coopeeo/shipwrecked-pcb/README.md

View this project on [CADLAB.io](https://cadlab.io/project/29385). 

# shipwrecked-pcb
Shipwrecked PCB Badges
