coopeeo/shipwrecked-pcb/PCB-Schematic/shipwreckedpcb/production/settings.md

# Fabrication Settings

| Name | Value |
|---|---|
| Layers | 4 |
| Stackup (JLC Only) | 3313 |
| Thickness | 1.6mm |
