coopeeo/shipwrecked-pcb/PCB-Schematic/shipwreckedpcb/production/shipwreckedpcb-bom.csv

Reference | Qty | Comment | Footprint | LCSC Part
C1,C2,C5,C6,C7,C8,C9,C10,C11,C12,C56,C65,C66 | 13 | 100nF | Capacitor_SMD:C_0603_1608Metric | C14663
C3,C4,C15,C16,C17,C18,C19,C20,C23,C26,C52 | 11 | 1uF 25v | Capacitor_SMD:C_0603_1608Metric | C15849
C13,C14 | 2 | 15pF | Capacitor_SMD:C_0603_1608Metric | C1644
C21,C22 | 2 | 4.7uF 25v | Capacitor_SMD:C_0603_1608Metric | C69335
C51,C53,C54,C55,C60,C61 | 6 | 10uF | Capacitor_SMD:C_0603_1608Metric | C96446
C57 | 1 | 47nF | Capacitor_SMD:C_0603_1608Metric | C1622
C62 | 1 | 47pF | Capacitor_SMD:C_0603_1608Metric | C1671
C63 | 1 | 39pF | Capacitor_SMD:C_0603_1608Metric | C1666
C64 | 1 | 1nF | Capacitor_SMD:C_0603_1608Metric | C1588
C67 | 1 | 470nF | Capacitor_SMD:C_0603_1608Metric | C1623
C68,C69 | 2 | 3.3pF | Capacitor_SMD:C_0603_1608Metric | C1660
D1 | 1 | D | Diode_SMD:D_SOD-123F | C2892326
D2,D3,D4 | 3 | MBR0530 | Diode_SMD:D_SOD-123 | C77336
FB1 | 1 | BLM18AG601SN1D | Resistor_SMD:R_0603_1608Metric | C19330
FL1 | 1 | 0900FM15D0039 - CONSIGNED | RF_Converter:Balun_Johanson_0900FM15K0039 | C1513363
J1 | 1 | USB4105 | Connector_USB:USB_C_Receptacle_GCT_USB4105-xx-A_16P_TopMnt_Horizontal | C3020560
J2 | 1 | Waveshare 1.54" E-Ink | Connector_FFC-FPC:TE_2-1734839-4_1x24-1MP_P0.5mm_Horizontal | C5362165
L1 | 1 | 10uH | Inductor_SMD:L_APV_ANR4018 | C167808
L9 | 1 | 2.2uH | Inductor_SMD:L_Taiyo-Yuden_NR-30xx | C6364793
L10 | 1 | 47nH | Inductor_SMD:L_0603_1608Metric | C285885
L11 | 1 | 15uH | Inductor_SMD:L_0805_2012Metric | C383402
L12 | 1 | 9.1nH | Inductor_SMD:L_0603_1608Metric | C77125
Q1 | 1 | Si1308EDL | Package_TO_SOT_SMD:SOT-323_SC-70 | C7603347
R1,R7 | 2 | 1k | Resistor_SMD:R_0603_1608Metric | C21190
R2,R3 | 2 | 27.4 | Resistor_SMD:R_0603_1608Metric | C22926
R4,R5 | 2 | 5k1 | Resistor_SMD:R_0603_1608Metric | C23186
R6,R20,R21,R22 | 4 | 10k | Resistor_SMD:R_0603_1608Metric | C25804
R8 | 1 | 2.2 | Resistor_SMD:R_0603_1608Metric | C22939
R9,R18 | 2 | 1M | Resistor_SMD:R_0603_1608Metric | C22935
R19 | 1 | 180k | Resistor_SMD:R_0603_1608Metric | C22827
R23 | 1 | 100 | Resistor_SMD:R_0603_1608Metric | C22775
R24 | 1 | 330 | Resistor_SMD:R_0603_1608Metric | C23138
SW1 | 1 | BOOTSEL | Button_Switch_SMD:SW_Tactile_SPST_NO_Straight_CK_PTS636Sx25SMTRLFS | C318938
SW2 | 1 | RESET | Button_Switch_SMD:SW_Tactile_SPST_NO_Straight_CK_PTS636Sx25SMTRLFS | C318938
SW19 | 1 | PWR Switch | Button_Switch_SMD:SW_SPDT_PCM12 | C319020
U1 | 1 | RP2040 | Package_DFN_QFN:QFN-56-1EP_7x7mm_P0.4mm_EP3.2x3.2mm | C2040
U2 | 1 | W25Q128JVS | Package_SO:SOIC-8_5.3x5.3mm_P1.27mm | C97521
U3 | 1 | PE4259 | Package_TO_SOT_SMD:SOT-363_SC-70-6 | C470892
U4 | 1 | TPS61200DRC | Package_SON:Texas_S-PVSON-N10_ThermalVias | C140320
U6 | 1 | AMS1117-3.3 | Package_TO_SOT_SMD:SOT-223-3_TabPin2 | C18906017
U7 | 1 | PCA9555PW | Package_SO:TSSOP-24_4.4x7.8mm_P0.65mm | C128392
U8 | 1 | SX1262IMLTRT | Package_DFN_QFN:QFN-24-1EP_4x4mm_P0.5mm_EP2.6x2.6mm | C191341
Y1 | 1 | 12MHz | Crystal:Crystal_SMD_Abracon_ABM8G-4Pin_3.2x2.5mm | C9002
Y2 | 1 | 32MHz | Crystal:Crystal_SMD_3225-4Pin_3.2x2.5mm | C19723365
