coopeeo/shipwrecked-pcb/PCB-Schematic/shipwreckedpcb/shipwreckedpcb.kicad_pcb

## KiCad design PCB-Schematic/shipwreckedpcb/shipwreckedpcb.kicad_pcb (2025-08-02)

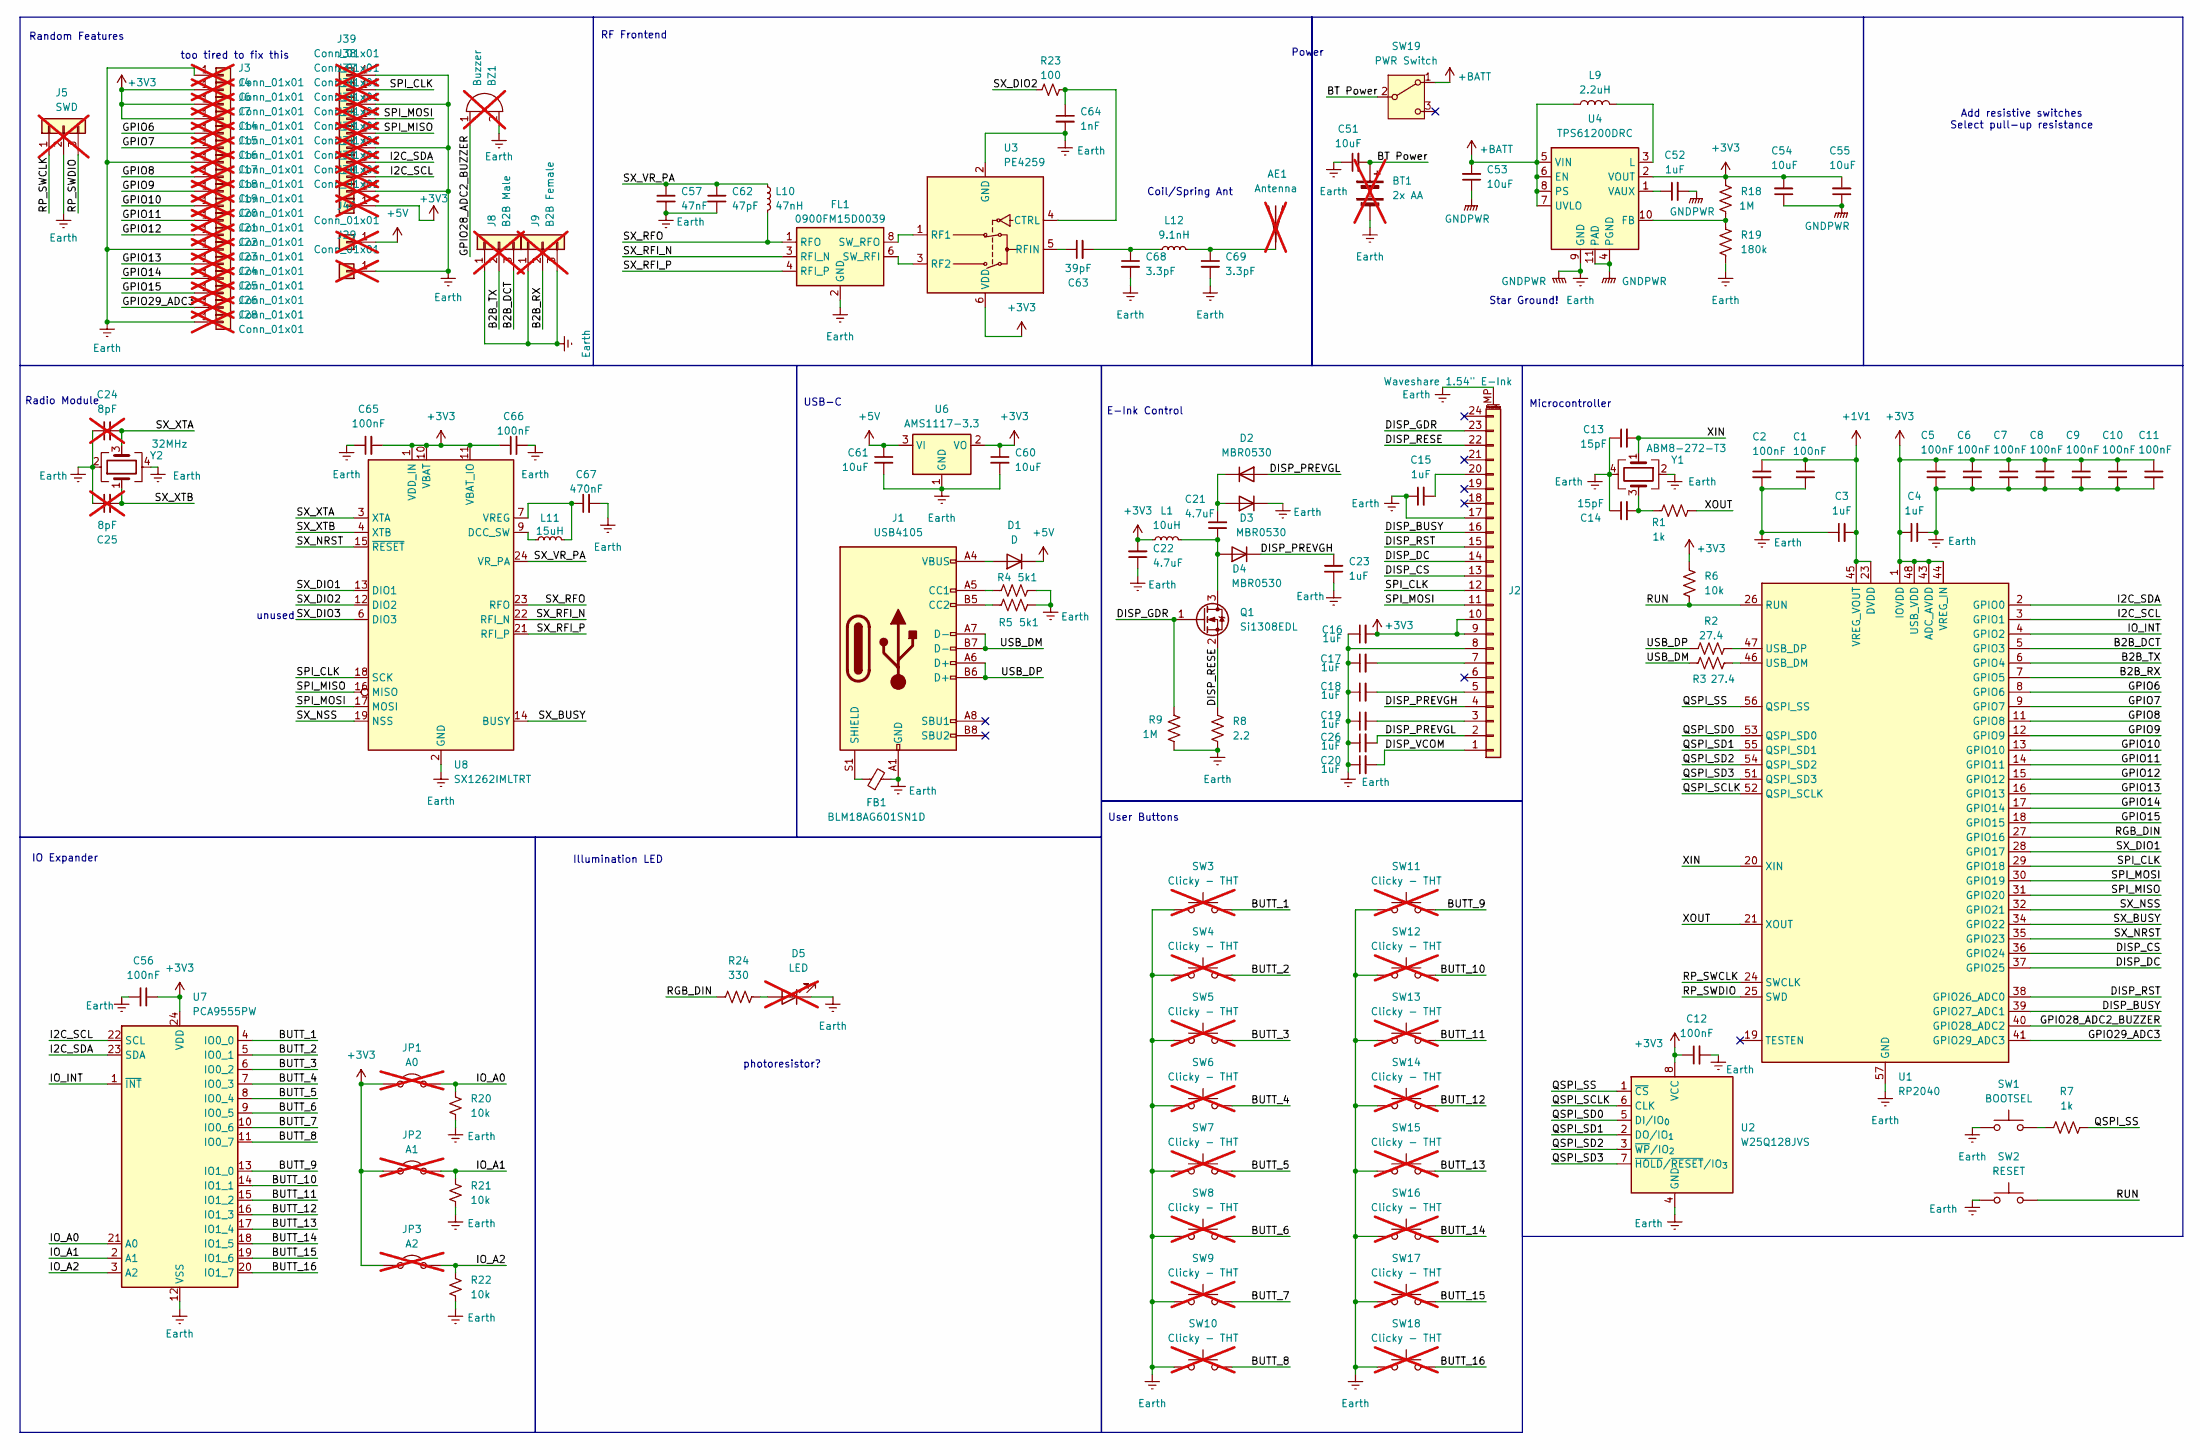
[picture p1: schematic shipwreckedpcb.kicad_sch]

Parts:
AE1: Antenna; PinSocket_1x01_P2.54mm_Vertical; not fitted
BT1: 2x AA; BatteryHolder_Keystone_2462_2xAA; not fitted
BZ1: Buzzer; Buzzer_D14mm_H7mm_P10mm; not fitted
C1, C2, C5, C6, C7, C8, C9, C10, C11, C12, C56, C65, C66: 100nF; C_0603_1608Metric; MPN CC0603KRX7R9BB104; LCSC Part C14663
C3, C4, C15, C16, C17, C18, C19, C20, C23, C26, C52: 1uF; C_0603_1608Metric; MPN CL10A105KB8NNNC; LCSC Part C15849
C13, C14: 15pF; C_0603_1608Metric; MPN CC0603JRNPO9BN150; LCSC Part C1644
C21, C22: 4.7uF; C_0603_1608Metric; MPN CL10A475KA8NQNC; LCSC Part C69335
C24, C25: 8pF; C_0603_1608Metric; MPN CC0603CRNPO9BN8R0; not fitted
C51, C53, C54, C55, C60, C61: 10uF; C_0603_1608Metric; MPN CL10A106KP8NNNC; LCSC Part C96446
C57: 47nF; C_0603_1608Metric; MPN CC0603KRX7R9BB473; LCSC Part C1622
C62: 47pF; C_0603_1608Metric; MPN CC0603JRNPO9BN470; LCSC Part C1671
C63: 39pF; C_0603_1608Metric; MPN CC0603JRNPO9BN101; LCSC Part C1666
C64: 1nF; C_0603_1608Metric; MPN CC0603KRX7R9BB102; LCSC Part C1588
C67: 470nF; C_0603_1608Metric; MPN CL10B474KA8NNNC; LCSC Part C1623
C68, C69: 3.3pF; C_0603_1608Metric; MPN 0603CG3R3C500NT; LCSC Part C1660
D1: D; D_SOD-123F; MPN 1N4001; LCSC Part C2892326
D2, D3, D4: MBR0530; D_SOD-123; MPN MBR0530T1G; LCSC Part C77336
D5: LED; LED_D5.0mm; MPN DY-324SVRC-H23-P-A4(FH); not fitted
FB1: BLM18AG601SN1D; R_0603_1608Metric; MPN BLM18AG601SN1D; LCSC Part C19330
FL1: 0900FM15D0039; Balun_Johanson_0900FM15K0039; MPN 0900FM15K0039E; LCSC Part consigned
J1: USB4105; USB_C_Receptacle_GCT_USB4105-xx-A_16P_TopMnt_Horizontal; MPN USB4105-GF-A; LCSC Part C3020560
J2: Waveshare 1.54" E-Ink; TE_2-1734839-4_1x24-1MP_P0.5mm_Horizontal; MPN 05B20U24P; LCSC Part C5362165
J3, J4, J6, J7, J14, J15, J16, J17, J18, J19, J20, J21, J22, J23, J24, J25, J26, J28, J29, J30, J31, J32, J33, J34, J35, J36, J37, J38, J39, J40: Conn_01x01; SolderWirePad_1x01_SMD_1x2mm; not fitted
J5: SWD; PinSocket_1x03_P2.54mm_Vertical; not fitted
J8: B2B Male; PinHeader_1x03_P2.54mm_Horizontal; not fitted
J9: B2B Female; PinSocket_1x03_P2.54mm_Horizontal; not fitted
JP1: A0; SolderJumper-2_P1.3mm_Open_RoundedPad1.0x1.5mm; not fitted
JP2: A1; SolderJumper-2_P1.3mm_Open_RoundedPad1.0x1.5mm; not fitted
JP3: A2; SolderJumper-2_P1.3mm_Open_RoundedPad1.0x1.5mm; not fitted
L1: 10uH; L_APV_ANR4018; MPN FNR4018S100MT; LCSC Part C167808
L9: 2.2uH; L_Taiyo-Yuden_NR-30xx; MPN NR3015T2R2M; LCSC Part C6364793
L10: 47nH; L_0603_1608Metric; MPN LS0603-47NJ-N; LCSC Part C285885
L11: 15uH; L_0805_2012Metric; MPN MLZ2012M150WT000; LCSC Part C383402
L12: 9.1nH; L_0603_1608Metric; MPN LS0603-47NJ-N; LCSC Part C334262
Q1: Si1308EDL; SOT-323_SC-70; MPN SI1308EDL; LCSC Part C7603347
R1, R7: 1k; R_0603_1608Metric; MPN RC0603FR-071KL; LCSC Part C21190
R2, R3: 27.4; R_0603_1608Metric; MPN FRC0603F27R4TS; LCSC Part C22926
R4, R5: 5k1; R_0603_1608Metric; MPN FRC0603F5101TS; LCSC Part C23186
R6, R20, R21, R22: 10k; R_0603_1608Metric; MPN RC0603FR-0710KL; LCSC Part C25804
R8: 2.2; R_0603_1608Metric; MPN CRCW06033R00FKEA; LCSC Part C22939
R9, R18: 1M; R_0603_1608Metric; MPN RC0603FR-071ML; LCSC Part C22935
R19: 180k; R_0603_1608Metric; MPN FRC0603F1803TS; LCSC Part C22827
R23: 100; R_0603_1608Metric; MPN RC0603FR-07100RL; LCSC Part C22775
R24: 330; R_0603_1608Metric; MPN RC0603FR-07330RL; LCSC Part C23138
SW1: BOOTSEL; SW_Tactile_SPST_NO_Straight_CK_PTS636Sx25SMTRLFS; MPN TS-1101-C-W; LCSC Part C318938
SW2: RESET; SW_Tactile_SPST_NO_Straight_CK_PTS636Sx25SMTRLFS; MPN TS-1101-C-W; LCSC Part C318938
SW3, SW4, SW5, SW6, SW7, SW8, SW9, SW10, SW11, SW12, SW13, SW14, SW15, SW16, SW17, SW18: Clicky - THT; SW_PUSH_6mm; MPN SH-6X6X4.3H-CJ; not fitted
SW19: PWR Switch; SW_SPDT_PCM12; MPN SK-3296S-01-L1; LCSC Part C319020
U1: RP2040; QFN-56-1EP_7x7mm_P0.4mm_EP3.2x3.2mm; MPN RP2040; LCSC Part C2040
U2: W25Q128JVS; SOIC-8_5.3x5.3mm_P1.27mm; MPN W25Q128JVSIQ; LCSC Part C97521
U3: PE4259; SOT-363_SC-70-6; MPN PE4259-63; LCSC Part C470892
U4: TPS61200DRC; Texas_S-PVSON-N10_ThermalVias; MPN TPS61200DRCR; LCSC Part C140320
U6: AMS1117-3.3; SOT-223-3_TabPin2; MPN AMS1117-3.3V; LCSC Part C18906017
U7: PCA9555PW; TSSOP-24_4.4x7.8mm_P0.65mm; MPN PCA9555PW,118; LCSC Part C128392
U8: SX1262IMLTRT; QFN-24-1EP_4x4mm_P0.5mm_EP2.6x2.6mm; MPN SX1262IMLTRT; LCSC Part C191341
Y1: ABM8-272-T3; Crystal_SMD_Abracon_ABM8G-4Pin_3.2x2.5mm; MPN XL2EL89CMI-111YLC-12M; LCSC Part C9002
Y2: 32MHz; Crystal_SMD_3225-4Pin_3.2x2.5mm; MPN XTM32032000DT00351001; LCSC Part C19723365

Connections:
+1V1: C1.1, C2.1, C3.2, U1.23 (DVDD), U1.45 (VREG_VOUT), U1.50 (DVDD)
+3V3: C4.1, C5.1, C6.1, C7.1, C8.1, C9.1, C10.1, C11.1, C12.1, C16.2, C22.2, C54.2, C55.2, C56.1, C60.1, C65.2, C66.1, J2.9, J2.10, J4.1, J6.1, J7.1, J30.1, JP1.1 (A), JP2.1 (A), JP3.1 (A), L1.1, R6.1, R18.1, U1.1 (IOVDD), U1.10 (IOVDD), U1.22 (IOVDD), U1.33 (IOVDD), U1.42 (IOVDD), U1.43 (ADC_AVDD), U1.44 (VREG_IN), U1.48 (USB_VDD), U1.49 (IOVDD), U2.8 (VCC), U3.6 (VDD), U4.2 (VOUT), U6.2 (VO), U7.24 (VDD), U8.1 (VDD_IN), U8.10 (VBAT), U8.11 (VBAT_IO)
+5V: C61.1, D1.1 (K), J40.1, U6.3 (VI)
+BATT: C53.2, L9.1, SW19.1 (A), U4.5 (VIN), U4.6 (EN), U4.7 (UVLO), U4.8 (PS)
/B2B_DCT: J8.3, U1.5 (GPIO3)
/B2B_RX: J9.2, U1.7 (GPIO5)
/B2B_TX: J8.2, U1.6 (GPIO4)
/BT Power: BT1.1 (+), C51.2, SW19.2 (B)
/BUTT_1: SW3.2, U7.4 (IO0_0)
/BUTT_2: SW4.2, U7.5 (IO0_1)
/BUTT_3: SW5.2, U7.6 (IO0_2)
/BUTT_4: SW6.2, U7.7 (IO0_3)
/BUTT_5: SW7.2, U7.8 (IO0_4)
/BUTT_6: SW8.2, U7.9 (IO0_5)
/BUTT_7: SW9.2, U7.10 (IO0_6)
/BUTT_8: SW10.2, U7.11 (IO0_7)
/BUTT_9: SW11.2, U7.13 (IO1_0)
/BUTT_10: SW12.2, U7.14 (IO1_1)
/BUTT_11: SW13.2, U7.15 (IO1_2)
/BUTT_12: SW14.2, U7.16 (IO1_3)
/BUTT_13: SW15.2, U7.17 (IO1_4)
/BUTT_14: SW16.2, U7.18 (IO1_5)
/BUTT_15: SW17.2, U7.19 (IO1_6)
/BUTT_16: SW18.2, U7.20 (IO1_7)
/DISP_BUSY: J2.16, U1.39 (GPIO27_ADC1)
/DISP_CS: J2.13, U1.36 (GPIO24)
/DISP_DC: J2.14, U1.37 (GPIO25)
/DISP_GDR: J2.23, Q1.1 (G), R9.1
/DISP_PREVGH: C23.2, D4.1 (K), J2.4
/DISP_PREVGL: C26.2, D2.2 (A), J2.2
/DISP_RESE: J2.22, Q1.2 (S), R8.1
/DISP_RST: J2.15, U1.38 (GPIO26_ADC0)
/DISP_VCOM: C20.2, J2.1
/GPIO6: J14.1, U1.8 (GPIO6)
/GPIO7: J15.1, U1.9 (GPIO7)
/GPIO8: J17.1, U1.11 (GPIO8)
/GPIO9: J18.1, U1.12 (GPIO9)
/GPIO10: J19.1, U1.13 (GPIO10)
/GPIO11: J20.1, U1.14 (GPIO11)
/GPIO12: J21.1, U1.15 (GPIO12)
/GPIO13: J23.1, U1.16 (GPIO13)
/GPIO14: J24.1, U1.17 (GPIO14)
/GPIO15: J25.1, U1.18 (GPIO15)
/GPIO28_ADC2_BUZZER: BZ1.1 (+), U1.40 (GPIO28_ADC2)
/GPIO29_ADC3: J26.1, U1.41 (GPIO29_ADC3)
/I2C_SCL: J32.1, U1.3 (GPIO1), U7.22 (SCL)
/I2C_SDA: J33.1, U1.2 (GPIO0), U7.23 (SDA)
/IO_A0: JP1.2 (B), R20.1, U7.21 (A0)
/IO_A1: JP2.2 (B), R21.1, U7.2 (A1)
/IO_A2: JP3.2 (B), R22.1, U7.3 (A2)
/IO_INT: U1.4 (GPIO2), U7.1 (~INT)
/QSPI_SCLK: U1.52 (QSPI_SCLK), U2.6 (CLK)
/QSPI_SD0: U1.53 (QSPI_SD0), U2.5 (DI/IO_{0})
/QSPI_SD1: U1.55 (QSPI_SD1), U2.2 (DO/IO_{1})
/QSPI_SD2: U1.54 (QSPI_SD2), U2.3 (~WP/IO_{2})
/QSPI_SD3: U1.51 (QSPI_SD3), U2.7 (~HOLD/~RESET/IO_{3})
/QSPI_SS: R7.2, U1.56 (QSPI_SS), U2.1 (~CS)
/RGB_DIN: R24.1, U1.27 (GPIO16)
/RP_SWCLK: J5.1, U1.24 (SWCLK)
/RP_SWDIO: J5.3, U1.25 (SWD)
/RUN: R6.2, SW2.2, U1.26 (RUN)
/SPI_CLK: J2.12, J38.1, U1.29 (GPIO18), U8.18 (SCK)
/SPI_MISO: J35.1, U1.31 (GPIO20), U8.16 (MISO)
/SPI_MOSI: J2.11, J36.1, U1.30 (GPIO19), U8.17 (MOSI)
/SX_BUSY: U1.34 (GPIO22), U8.14 (BUSY)
/SX_DIO1: U1.28 (GPIO17), U8.13 (DIO1)
/SX_DIO2: R23.1, U8.12 (DIO2)
/SX_DIO3: U8.6 (DIO3)
/SX_NRST: U1.35 (GPIO23), U8.15 (~RESET)
/SX_NSS: U1.32 (GPIO21), U8.19 (NSS)
/SX_RFI_N: FL1.3 (RFI_N), U8.22 (RFI_N)
/SX_RFI_P: FL1.4 (RFI_P), U8.21 (RFI_P)
/SX_RFO: FL1.1 (RFO), L10.2, U8.23 (RFO)
/SX_VR_PA: C57.1, C62.1, L10.1, U8.24 (VR_PA)
/SX_XTA: C24.2, U8.3 (XTA), Y2.3
/SX_XTB: C25.2, U8.4 (XTB), Y2.1
/USB_DM: J1.A7 (D-), J1.B7 (D-), R3.1
/USB_DP: J1.A6 (D+), J1.B6 (D+), R2.1
/XIN: C13.2, U1.20 (XIN), Y1.1
/XOUT: R1.2, U1.21 (XOUT)
Earth: BT1.2 (-), BZ1.2 (-), C1.2, C2.2, C3.1, C4.2, C5.2, C6.2, C7.2, C8.2, C9.2, C10.2, C11.2, C12.2, C13.1, C14.1, C15.1, C16.1, C17.1, C18.1, C19.1, C20.1, C22.1, C23.1, C24.1, C25.1, C26.1, C51.1, C52.2, C53.1, C54.1, C55.1, C56.2, C57.2, C60.2, C61.2, C62.2, C64.2, C65.1, C66.2, C67.2, C68.2, C69.2, D3.1 (K), D5.1 (K), FB1.2, FL1.2 (GND), FL1.5 (GND), FL1.7 (GND), FL1.9 (GND), FL1.10 (GND), J1.A1 (GND), J1.A12 (GND), J1.B1 (GND), J1.B12 (GND), J2.8, J2.17, J2.MP (MountPin), J3.1, J5.2, J8.1, J9.1, J9.3, J16.1, J22.1, J28.1, J29.1, J31.1, J34.1, J37.1, J39.1, R4.2, R5.2, R8.2, R9.2, R19.2, R20.2, R21.2, R22.2, SW1.1, SW2.1, SW3.1, SW4.1, SW5.1, SW6.1, SW7.1, SW8.1, SW9.1, SW10.1, SW11.1, SW12.1, SW13.1, SW14.1, SW15.1, SW16.1, SW17.1, SW18.1, U1.57 (GND), U2.4 (GND), U3.2 (GND), U4.4 (PGND), U4.9 (GND), U4.11 (PAD), U6.1 (GND), U7.12 (VSS), U8.2 (GND), U8.5 (GND), U8.8 (GND), U8.20 (GND), U8.25 (GND), Y1.2, Y1.4, Y2.2, Y2.4
unnamed: AE1.1 (A), C69.1, L12.2
unnamed: C14.2, R1.1, Y1.3
unnamed: C63.2, C68.1, L12.1
unnamed: D1.2 (A), J1.A4 (VBUS), J1.A9 (VBUS), J1.B4 (VBUS), J1.B9 (VBUS)
unnamed: C21.2, D2.1 (K), D3.2 (A)
unnamed: C21.1, D4.2 (A), L1.2, Q1.3 (D)
unnamed: D5.2 (A), R24.2
unnamed: FL1.6 (SW_RFI), U3.3 (RF2)
unnamed: FL1.8 (SW_RFO), U3.1 (RF1)
unnamed: J1.A5 (CC1), R4.1
unnamed: J1.B5 (CC2), R5.1
unnamed: FB1.1, J1.S1 (SHIELD)
unnamed: C19.2, J2.3
unnamed: C18.2, J2.5
unnamed: C17.2, J2.7
unnamed: C15.2, J2.20
unnamed: R7.1, SW1.2
unnamed: R3.2, U1.46 (USB_DM)
unnamed: R2.2, U1.47 (USB_DP)
unnamed: C64.1, R23.2, U3.4 (CTRL)
unnamed: C63.1, U3.5 (RFIN)
unnamed: R18.2, R19.1, U4.10 (FB)
unnamed: L9.2, U4.3 (L)
unnamed: C52.1, U4.1 (VAUX)
unnamed: L11.1, U8.9 (DCC_SW)
unnamed: C67.1, L11.2, U8.7 (VREG)

Notes on the sheet:
IO Expander
photoresistor?
Illumination LED
Power
Add resistive switches Select pull-up resistance
Microcontroller
E-Ink Control
unused
User Buttons
Star Ground!
too tired to fix this
Coil/Spring Ant
Random Features
RF Frontend
USB-C
Radio Module

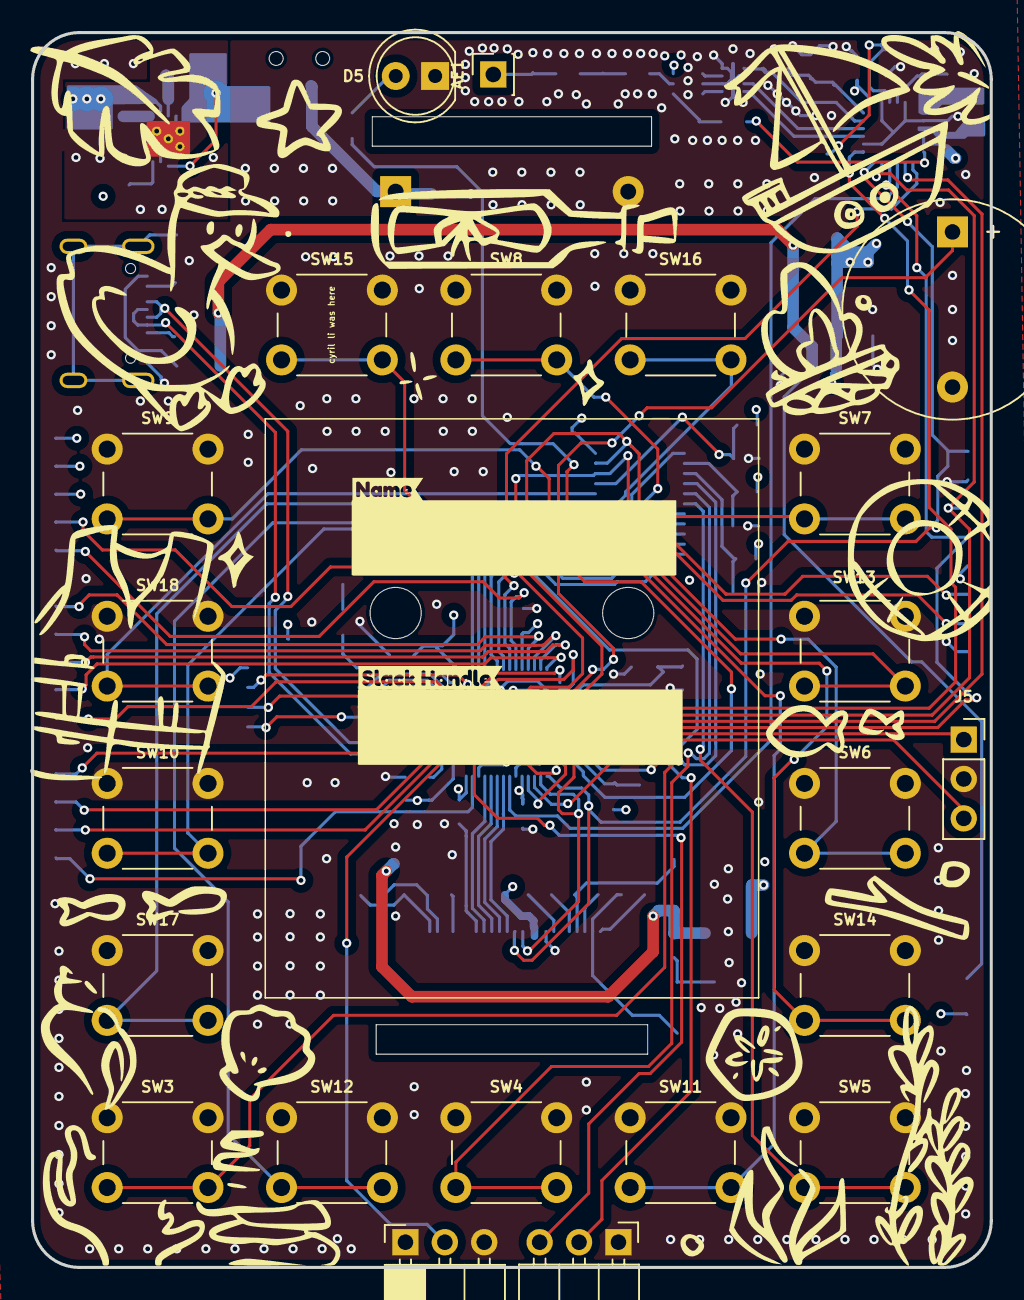
[picture p2: board shipwreckedpcb.kicad_pcb from above]

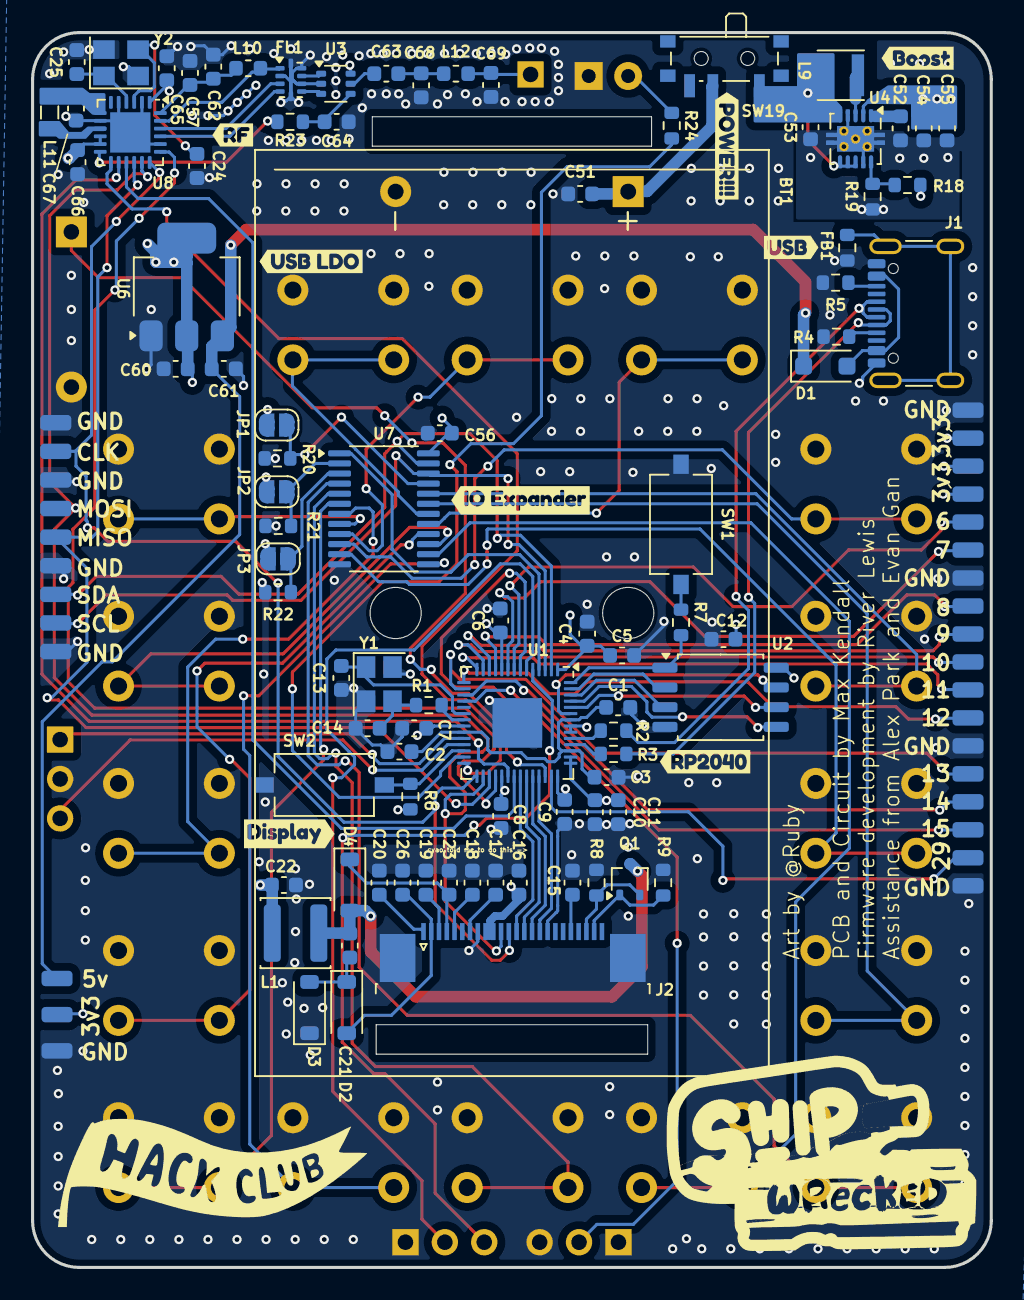
[picture p3: board shipwreckedpcb.kicad_pcb from below]

Board: 4 copper layers, 61.8 x 79.6 mm, 151 parts (127 on the bottom side), 106 nets.

Other parts of the board:
kibuzzard-687A9D67: G***; kibuzzard-687A9D67
kibuzzard-687A9DB2: G***; kibuzzard-687A9DB2
kibuzzard-687ADB8B: G***; kibuzzard-687ADB8B
kibuzzard-687864C4: G***; kibuzzard-687864C4
kibuzzard-687865CB: G***; kibuzzard-687865CB
kibuzzard-6878653F: G***; kibuzzard-6878653F
kibuzzard-6878659A: G***; kibuzzard-6878659A
kibuzzard-68786508: G***; kibuzzard-68786508
kibuzzard-68786528: G***; kibuzzard-68786528
kibuzzard-68786588: G***; kibuzzard-68786588
