coopeeo/shipwrecked-pcb/Code/internal_os/notifs.py

class NotifManager:
    """
    The NotifManager class is responsible for managing notifications on the badge.
    It handles notification creation, display, and interaction.
    """
    # TODO
    pass
