coopeeo/shipwrecked-pcb/badge-selftest/disp/main.py

import machine
import utime

#EPD GPIO
isEPD_W21_BUSY=machine.Pin(27, machine.Pin.IN, machine.Pin.PULL_DOWN) #BUSY
EPD_W21_RST= machine.Pin(26, machine.Pin.OUT)#RESE
EPD_W21_DC= machine.Pin(25, machine.Pin.OUT)#DC
EPD_W21_CS= machine.Pin(24, machine.Pin.OUT)#CS
#SPI0
spi_sck=machine.Pin(18) #SCLK
spi_tx=machine.Pin(19)#SDIN
spi_rx=machine.Pin(20)
spi=machine.SPI(0,baudrate=10000000,sck=spi_sck, mosi=spi_tx, miso=spi_rx) #10Mhz

#LED
led_onboard = machine.Pin(16, machine.Pin.OUT)
#PICTURE
Num= [
#0
[
0XFF,0XFF,0XFF,0XFF,0XFF,0XFF,0XFF,0XFF,0XFF,0XFF,0XFF,0XFF,0XFF,0XFF,0XFF,0XFF,
0XFF,0XFF,0XFF,0XE0,0X03,0XFF,0XFF,0XFF,0XFF,0XFF,0XFC,0X00,0X00,0X1F,0XFF,0XFF,
0XFF,0XFF,0XE0,0X00,0X00,0X03,0XFF,0XFF,0XFF,0XFF,0X80,0X00,0X00,0X00,0XFF,0XFF,
0XFF,0XFE,0X00,0X00,0X00,0X00,0X3F,0XFF,0XFF,0XFC,0X00,0X00,0X00,0X00,0X1F,0XFF,
0XFF,0XF8,0X00,0X00,0X00,0X00,0X0F,0XFF,0XFF,0XF0,0X03,0XFF,0XFF,0XE0,0X07,0XFF,
0XFF,0XE0,0X3F,0XFF,0XFF,0XFE,0X03,0XFF,0XFF,0XE0,0XFF,0XFF,0XFF,0XFF,0X83,0XFF,
0XFF,0XC1,0XFF,0XFF,0XFF,0XFF,0XC1,0XFF,0XFF,0XC7,0XFF,0XFF,0XFF,0XFF,0XF1,0XFF,
0XFF,0XC7,0XFF,0XFF,0XFF,0XFF,0XF1,0XFF,0XFF,0XCF,0XFF,0XFF,0XFF,0XFF,0XF9,0XFF,
0XFF,0XCF,0XFF,0XFF,0XFF,0XFF,0XF9,0XFF,0XFF,0XC7,0XFF,0XFF,0XFF,0XFF,0XF1,0XFF,
0XFF,0XC7,0XFF,0XFF,0XFF,0XFF,0XF1,0XFF,0XFF,0XC3,0XFF,0XFF,0XFF,0XFF,0XE1,0XFF,
0XFF,0XE0,0XFF,0XFF,0XFF,0XFF,0X83,0XFF,0XFF,0XE0,0X3F,0XFF,0XFF,0XFE,0X03,0XFF,
0XFF,0XF0,0X03,0XFF,0XFF,0XC0,0X07,0XFF,0XFF,0XF8,0X00,0X00,0X00,0X00,0X0F,0XFF,
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

    Epaper_Write_Command(0x45) #set Ram-Y address start/end position          
    Epaper_Write_Data(0xC7)    #0xC7-->(199+1)=200
    Epaper_Write_Data(0x00)
    Epaper_Write_Data(0x00)
    Epaper_Write_Data(0x00) 

    Epaper_Write_Command(0x3C) #BorderWavefrom,
    Epaper_Write_Data(0x05)	

    Epaper_Write_Command(0x18) #Read built-in temperature sensor
    Epaper_Write_Data(0x80)	

    Epaper_Write_Command(0x4E)   # set RAM x address count to 0
    Epaper_Write_Data(0x00)
    Epaper_Write_Command(0x4F)   # set RAM y address count to 0X199    
    Epaper_Write_Data(0xC7)
    Epaper_Write_Data(0x00)
    Epaper_READBUSY()
	
def EPD_Update(): 
    Epaper_Write_Command(0x22) #Display Update Control
    Epaper_Write_Data(0xF7)   
    Epaper_Write_Command(0x20) #Activate Display Update Sequence
    Epaper_READBUSY()   

#When the electronic paper screen is updated, do not unplug the electronic paper to avoid damage to the screen*/
def EPD_Part_Update():
	Epaper_Write_Command(0x22) #Display Update Control
	Epaper_Write_Data(0xFF)   
	Epaper_Write_Command(0x20) #Activate Display Update Sequence
	Epaper_READBUSY() 			

#display 
def EPD_WhiteScreen_ALL(datas):
    Epaper_Write_Command(0x24)   #write RAM for black(0)/white (1)
    for i in range(5000):             
        Epaper_Write_Data(datas[i])
    EPD_Update()	 

#The x axis is reduced by one byte, and the y axis is reduced by one pixel.
def EPD_SetRAMValue_BaseMap(datas):	
    Epaper_Write_Command(0x24)   #Write Black and White image to RAM
    for i in range(5000):             
        Epaper_Write_Data(datas[i])
    Epaper_Write_Command(0x26)   #Write Black and White image to RAM
    for i in range(5000):             
        Epaper_Write_Data(datas[i])
    EPD_Update()		 

def EPD_Dis_Part(x_start,y_start,datas,PART_COLUMN,PART_LINE):
    x_start=x_start//8
    x_end=x_start+PART_LINE//8-1 

    y_start1=0
    y_start2=y_start
    if y_start>=256:
        y_start1=y_start2//256
        y_start2=y_start2%256	
    y_end1=0
    y_end2=y_start+PART_COLUMN-1
    if y_end2>=256:
        y_end1=y_end2//256
        y_end2=y_end2%256				
    #Add hardware reset to prevent background color change
    EPD_W21_RST.value(0)  # Module reset   
    utime.sleep(0.01)#At least 10ms delay 
    EPD_W21_RST.value(1)
    utime.sleep(0.01) #At least 10ms delay 	
    #Lock the border to prevent flashing
    Epaper_Write_Command(0x3C) #BorderWavefrom,
    Epaper_Write_Data(0x80)	
    #
    Epaper_Write_Command(0x44)       # set RAM x address start/end, in page 35
    Epaper_Write_Data(x_start)    # RAM x address start at 00h
    Epaper_Write_Data(x_end)    # RAM x address end at 0fh(15+1)*8->128 
    Epaper_Write_Command(0x45)       # set RAM y address start/end, in page 35
    Epaper_Write_Data(y_start2)    # RAM y address start at 0127h
    Epaper_Write_Data(y_start1)    # RAM y address start at 0127h
    Epaper_Write_Data(y_end2)    # RAM y address end at 00h
    Epaper_Write_Data(y_end1)    # ????=0	

    Epaper_Write_Command(0x4E)   # set RAM x address count to 0
    Epaper_Write_Data(x_start) 
    Epaper_Write_Command(0x4F)   # set RAM y address count to 0X127    
    Epaper_Write_Data(y_start2)
    Epaper_Write_Data(y_start1)

    Epaper_Write_Command(0x24)   #Write Black and White image to RAM 
    for i in range(PART_COLUMN*PART_LINE//8):                       
        Epaper_Write_Data(datas[i])
    EPD_Part_Update()


#Clear screen
def PIC_display_Clear():
    #Write Data
    Epaper_Write_Command(0x24)	       #Transfer old data
    for i in range(5000):  	
        Epaper_Write_Data(0xFF) 
    #Refresh
    EPD_Update()
#Enter deep sleep mode 
def EPD_DeepSleep(): 	
    Epaper_Write_Command(0x10) #enter deep sleep
    Epaper_Write_Data(0x01) 
    utime.sleep(0.01)

##################/TIME#########################/
def EPD_Dis_Part_myself(x_startA,y_startA,datasA,
	                    x_startB,y_startB,datasB,
			            x_startC,y_startC,datasC,
		                x_startD,y_startD,datasD,
					    x_startE,y_startE,datasE,PART_COLUMN,PART_LINE):	
	#Data A##############
    x_startA=x_startA//8#Convert to byte
    x_end=x_startA+PART_LINE//8-1 

    y_start1=0
    y_start2=y_startA-1
    if y_startA>=256:
        y_start1=y_start2//256
        y_start2=y_start2%256
    y_end1=0
    y_end2=y_startA+PART_COLUMN-1
    if y_end2>=256:
        y_end1=y_end2//256
        y_end2=y_end2%256				

    # Add hardware reset to prevent background color change
    EPD_W21_RST.value(0)  # Module reset   
    utime.sleep(0.01)#At least 10ms delay 
    EPD_W21_RST.value(1)
    utime.sleep(0.01) #At least 10ms delay 

    #Lock the border to prevent flashing
    Epaper_Write_Command(0x3C) #BorderWavefrom,
    Epaper_Write_Data(0x80)	
    #
    Epaper_Write_Command(0x44)       # set RAM x address start/end, in page 35
    Epaper_Write_Data(x_startA)    # RAM x address start at 00h
    Epaper_Write_Data(x_end)    # RAM x address end at 0fh(15+1)*8->128 
    Epaper_Write_Command(0x45)       # set RAM y address start/end, in page 35
    Epaper_Write_Data(y_start2)    # RAM y address start at 0127h
    Epaper_Write_Data(y_start1)    # RAM y address start at 0127h
    Epaper_Write_Data(y_end2)    # RAM y address end at 00h
    Epaper_Write_Data(y_end1)    

    Epaper_Write_Command(0x4E)   # set RAM x address count to 0
    Epaper_Write_Data(x_startA) 
    Epaper_Write_Command(0x4F)   # set RAM y address count to 0X127    
    Epaper_Write_Data(y_start2)
    Epaper_Write_Data(y_start1)

    Epaper_Write_Command(0x24)   #Write Black and White image to RAM
    for i in range(PART_COLUMN*PART_LINE//8):                         
        Epaper_Write_Data(datasA[i])

    #Data B##################/
    x_startB=x_startB//8#Convert to byte
    x_end=x_startB+PART_LINE//8-1 

    y_start1=0
    y_start2=y_startB-1
    if y_startB>=256:
        y_start1=y_start2//256
        y_start2=y_start2%256
    y_end1=0
    y_end2=y_startB+PART_COLUMN-1
    if y_end2>=256:
        y_end1=y_end2//256
        y_end2=y_end2%256			

    Epaper_Write_Command(0x44)       # set RAM x address start/end, in page 35
    Epaper_Write_Data(x_startB)    # RAM x address start at 00h
    Epaper_Write_Data(x_end)    # RAM x address end at 0fh(15+1)*8->128 
    Epaper_Write_Command(0x45)       # set RAM y address start/end, in page 35
    Epaper_Write_Data(y_start2)    # RAM y address start at 0127h
    Epaper_Write_Data(y_start1)    # RAM y address start at 0127h
    Epaper_Write_Data(y_end2)    # RAM y address end at 00h
    Epaper_Write_Data(y_end1)   

    Epaper_Write_Command(0x4E)   # set RAM x address count to 0
    Epaper_Write_Data(x_startB) 
    Epaper_Write_Command(0x4F)   # set RAM y address count to 0X127    
    Epaper_Write_Data(y_start2)
    Epaper_Write_Data(y_start1)

    Epaper_Write_Command(0x24)   #Write Black and White image to RAM
    for i in range(PART_COLUMN*PART_LINE//8):                         
        Epaper_Write_Data(datasB[i])	 

    #Data C###################
    x_startC=x_startC//8#Convert to byte
    x_end=x_startC+PART_LINE//8-1 

    y_start1=0
    y_start2=y_startC-1
    if y_startC>=256:
        y_start1=y_start2//256
        y_start2=y_start2%256	
    y_end1=0
    y_end2=y_startC+PART_COLUMN-1
    if y_end2>=256:
        y_end1=y_end2//256
        y_end2=y_end2%256					
    Epaper_Write_Command(0x44)       # set RAM x address start/end, in page 35
    Epaper_Write_Data(x_startC)    # RAM x address start at 00h
    Epaper_Write_Data(x_end)    # RAM x address end at 0fh(15+1)*8->128 
    Epaper_Write_Command(0x45)       # set RAM y address start/end, in page 35
    Epaper_Write_Data(y_start2)    # RAM y address start at 0127h
    Epaper_Write_Data(y_start1)    # RAM y address start at 0127h
    Epaper_Write_Data(y_end2)    # RAM y address end at 00h
    Epaper_Write_Data(y_end1)   

    Epaper_Write_Command(0x4E)   # set RAM x address count to 0
    Epaper_Write_Data(x_startC) 
    Epaper_Write_Command(0x4F)   # set RAM y address count to 0X127    
    Epaper_Write_Data(y_start2)
    Epaper_Write_Data(y_start1)


    Epaper_Write_Command(0x24)   #Write Black and White image to RAM
    for i in range(PART_COLUMN*PART_LINE//8):                         
        Epaper_Write_Data(datasC[i])	 	 

    #Data D###################
    x_startD=x_startD//8#Convert to byte
    x_end=x_startD+PART_LINE//8-1 

    y_start1=0
    y_start2=y_startD-1
    if y_startD>=256:
        y_start1=y_start2//256
        y_start2=y_start2%256
    y_end1=0
    y_end2=y_startD+PART_COLUMN-1
    if y_end2>=256:
        y_end1=y_end2//256
        y_end2=y_end2%256			

    Epaper_Write_Command(0x44)       # set RAM x address start/end, in page 35
    Epaper_Write_Data(x_startD)    # RAM x address start at 00h
    Epaper_Write_Data(x_end)        # RAM x address end at 0fh(15+1)*8->128 
    Epaper_Write_Command(0x45)       # set RAM y address start/end, in page 35
    Epaper_Write_Data(y_start2)    # RAM y address start at 0127h
    Epaper_Write_Data(y_start1)    # RAM y address start at 0127h
    Epaper_Write_Data(y_end2)    # RAM y address end at 00h
    Epaper_Write_Data(y_end1)    


    Epaper_Write_Command(0x4E)   # set RAM x address count to 0
    Epaper_Write_Data(x_startD) 
    Epaper_Write_Command(0x4F)   # set RAM y address count to 0X127    
    Epaper_Write_Data(y_start2)
    Epaper_Write_Data(y_start1)


    Epaper_Write_Command(0x24)   #Write Black and White image to RAM
    for i in range(PART_COLUMN*PART_LINE//8):                         
        Epaper_Write_Data(datasD[i])
    #Data E###################
    x_startE=x_startE//8#Convert to byte
    x_end=x_startE+PART_LINE//8-1 

    y_start1=0
    y_start2=y_startE-1
    if y_startE>=256:
        y_start1=y_start2//256
        y_start2=y_start2%256
    y_end1=0
    y_end2=y_startE+PART_COLUMN-1
    if y_end2>=256:
        y_end1=y_end2//256
        y_end2=y_end2%256				

    Epaper_Write_Command(0x44)       # set RAM x address start/end, in page 35
    Epaper_Write_Data(x_startE)    # RAM x address start at 00h
    Epaper_Write_Data(x_end)    # RAM x address end at 0fh(15+1)*8->128 
    Epaper_Write_Command(0x45)       # set RAM y address start/end, in page 35
    Epaper_Write_Data(y_start2)    # RAM y address start at 0127h
    Epaper_Write_Data(y_start1)    # RAM y address start at 0127h
    Epaper_Write_Data(y_end2)    # RAM y address end at 00h
    Epaper_Write_Data(y_end1)    


    Epaper_Write_Command(0x4E)   # set RAM x address count to 0
    Epaper_Write_Data(x_startE) 
    Epaper_Write_Command(0x4F)   # set RAM y address count to 0X127    
    Epaper_Write_Data(y_start2)
    Epaper_Write_Data(y_start1)

    Epaper_Write_Command(0x24)   #Write Black and White image to RAM
    for i in range(PART_COLUMN*PART_LINE//8):                         
        Epaper_Write_Data(datasE[i])  
    EPD_Part_Update()

 
#Main function part
while True:    
    #utime.sleep(7) #delay 3s
    print('now!')
    #Picture
	#Full screen refresh
    EPD_HW_Init() #Electronic paper initialization
    EPD_WhiteScreen_ALL(gImage_1) #Refresh the picture in full screen
    EPD_DeepSleep()#EPD_sleep,Sleep instruction is necessary, please do not delete!!!
    utime.sleep(3) #delay 3s

    #Clear
    EPD_HW_Init() #EPD init
    PIC_display_Clear()#EPD Clear
    EPD_DeepSleep()#EPD_sleep,Sleep instruction is necessary, please do not delete!!!
    utime.sleep(1) #delay 1s
    
###########Partial refresh time demo##################/
    EPD_HW_Init() #Electronic paper initialization	
    EPD_SetRAMValue_BaseMap(gImage_basemap) #Partial refresh background color  		
    '''
    EPD_Dis_Part(0,32,gImage_num1,32,32) #x,y,DATA,Resolution 32*32
    EPD_Dis_Part(0,32,gImage_num2,32,32) #x,y,DATA,Resolution 32*32
    EPD_Dis_Part(0,32,gImage_num3,32,32) #x,y,DATA,Resolution 32*32
    '''
    for i in range(6):  
        EPD_Dis_Part_myself(64,40,Num[i],
                         64,72,Num[0],
                         64,112,gImage_numdot,
                         64,154,Num[0],         
                         64,186,Num[0],32,64)	 #x-E,y-E,DATA-E,Resolution 32*64         
   
    #Clear
    EPD_HW_Init() #EPD init
    PIC_display_Clear()#EPD Clear
    EPD_DeepSleep()#EPD_sleep,Sleep instruction is necessary, please do not delete!!!
    utime.sleep(1) #delay 1s
    while 1: 
        print('WHY WONT IT WORK')
        led_onboard.toggle()
        utime.sleep(1) #delay 1s



 
    
    
    

   
    
    
    
