coopeeo/shipwrecked-pcb/(commit log)

2025-05-21 add local files
    [shipwreckedpcb.kicad_pcb, shipwreckedpcb.kicad_sch]
2025-05-21 move files to correct folder
    [shipwreckedpcb.kicad_pcb, shipwreckedpcb.kicad_sch]
2025-05-21 hopefully preview works now?
    [shipwreckedpcb.kicad_sch]
2025-05-22 finished first version of schematic
    [shipwreckedpcb.kicad_sch]
2025-05-23 add footprints for everything (just gotta sort out the touch pads)
    [shipwreckedpcb.kicad_sch]
2025-05-23 finish assigning footprints, made resistive button
    [shipwreckedpcb.kicad_sch]
2025-05-25 add power to lights (oops), lay out individual sections, add rough placement
    [shipwreckedpcb.kicad_pcb, shipwreckedpcb.kicad_sch]
2025-05-25 finish placing components
    [shipwreckedpcb.kicad_pcb]
2025-05-27 start routing
    [shipwreckedpcb.kicad_pcb]
2025-05-27 production files (tentative)
    [shipwrecked-bom.csv, shipwreckedpcb-centroid.csv, shipwreckedpcb.kicad_pcb, shipwreckedpcb.kicad_sch]
2025-05-27 boost conv, leds, caps, added ldo for usb
    [shipwreckedpcb.kicad_pcb, shipwreckedpcb.kicad_sch]
2025-05-29 finished buttons, removed nfc, routed interface headers
    [shipwreckedpcb.kicad_pcb, shipwreckedpcb.kicad_sch]
2025-05-30 made some progress with the expansion headers
    [shipwreckedpcb.kicad_pcb]
2025-05-31 finished all the gpio + buzzer
    [shipwreckedpcb.kicad_pcb, shipwreckedpcb.kicad_sch]
2025-06-24 fixed drc errors, added stitching vias
    [shipwreckedpcb.kicad_pcb]
2025-06-26 started sx1262
    [shipwreckedpcb.kicad_pcb, shipwreckedpcb.kicad_sch]
2025-06-27 finished prototype?
    [shipwreckedpcb.kicad_pcb, shipwreckedpcb.kicad_sch]
2025-06-27 silkscreen + prod files
    [shipwreckedpcb-B_Cu.gbr, shipwreckedpcb-B_Mask.gbr, shipwreckedpcb-B_Paste.gbr, shipwreckedpcb-B_Silkscreen.gbr, shipwreckedpcb-Edge_Cuts.gbr, shipwreckedpcb-F_Cu.gbr, shipwreckedpcb-F_Mask.gbr, shipwreckedpcb-F_Paste.gbr]
2025-06-27 add bom
    [shipwreckedpcb-bom.csv]
2025-07-15 fix dumb stuff
    turns out you need to:
    - give power :0
    - add vgl cap
    - not FLIP THE CONNECTOR :heavysob:
    - still need to do buttons
    [shipwreckedpcb.kicad_pcb, shipwreckedpcb.kicad_sch]
2025-07-15 first pass on clicky buttons
    [shipwreckedpcb.kicad_pcb, shipwreckedpcb.kicad_sch]
2025-07-18 that feeling when you do your homework on the bus
    [shipwreckedpcb.kicad_sch]
2025-07-18 avoiding alex's question (and shifting vias and fixing broken trace)
2025-07-18 crosstalk is a myth propagated by those in power
2025-07-18 silkscreen updates
    [shipwreckedpcb.kicad_pcb]
2025-07-18 if i didn't click update pcb from schematic i wouldn't have noticed i deleted the battery
    [shipwreckedpcb.kicad_pcb, shipwreckedpcb.kicad_sch]
2025-07-19 bom and buzzer
    [shipwreckedpcb.csv, shipwreckedpcb.kicad_pcb, shipwreckedpcb.kicad_sch]
2025-07-19 3d models
    [shipwreckedpcb.kicad_pcb]
2025-07-20 net lalbels neater
    [shipwreckedpcb.kicad_sch]
2025-07-21 add production files
    [shipwrecked-bom.csv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]
2025-07-22 THANK YOU CYRIL
    [shipwreckedpcb.kicad_pcb, shipwreckedpcb.kicad_sch]
2025-07-22 a via a day keeps the emi away
    [shipwreckedpcb.kicad_pcb]
2025-07-22 and jlc numbers, fix silkscreen
    [shipwreckedpcb.kicad_pcb, shipwreckedpcb.kicad_sch]
2025-07-22 new prod files
    [shipwreckedpcb-B_Cu.gbr, shipwreckedpcb-B_Mask.gbr, shipwreckedpcb-B_Paste.gbr, shipwreckedpcb-B_Silkscreen.gbr, shipwreckedpcb-Edge_Cuts.gbr, shipwreckedpcb-F_Cu.gbr, shipwreckedpcb-F_Mask.gbr, shipwreckedpcb-F_Paste.gbr]
2025-07-22 jlc-friendly files
    [shipwreckedpcb-bom.csv, shipwreckedpcb-centroid.csv]
2025-07-23 oops didn't mean to touch files outside of ./Code/*
    [main.py]
2025-07-30 Add nicer fonts and a badge app, and display errors on eink
    [apps.py, contacts.py, display.py, internalos.py, main.py, microfont.py]
2025-07-31 fix minor bug in buttons.py (webflasher test)
    [buttons.py]
2025-08-02 my git is very out of date :noo: fix self-test fix minor bugs in buttons + display fix 3d models in pcb
    [shipwreckedpcb.kicad_pcb]
2025-08-03 full length led
2025-08-07 add some uart stuff + make home screen use 2 buttons
2025-08-08 add led, add notifications to announcements
2025-08-08 use proper button names and switch from PermissionError to RuntimeError
2025-08-08 home screen on startup, feedback on button press
2025-08-08 fix wrapping on default badge text
    [main.py]
2025-08-08 text wrapping and default message fixes in announcements
    [main.py]
2025-08-08 fix home screen nav issues
    [main.py]
2025-08-08 some more progress on uart
2025-08-08 workaround for OSError 84 (untested)
    [microfont.py]
2025-08-09 Revert "close to final version"
    This reverts commit 66ef5ae6c3deaef1d89c793caf92375dbea4f24f.
    [internalos.py, main.py]
2025-08-09 correct a few things
    - correct page buttons on homescreen
    - add before close function working
    - add a little like light when SW15 is hit
    [apps.py, main.py]
